crowpilot-fc/crowmotion/main/output/ppm_output.c

// SPDX-License-Identifier: Apache-2.0
// Copyright 2026 Nitin Kumar
//
// Crowmotion - hardware-timed CPPM/PPM trainer output.

#include "ppm_output.h"

#include "driver/gpio.h"
#include "driver/rmt_tx.h"
#include "esp_private/gpio.h"
#include "esp_log.h"

static const char *TAG = "ppm";

#define PPM_RESOLUTION_HZ 1000000

static rmt_channel_handle_t s_channel;
static rmt_encoder_handle_t s_encoder;
static int s_gpio = -1;
static bool s_enabled;

esp_err_t ppm_output_init(int gpio_num)
{
    s_gpio = gpio_num;

    rmt_tx_channel_config_t channel_config = {
        .gpio_num = gpio_num,
        .clk_src = RMT_CLK_SRC_DEFAULT,
        .resolution_hz = PPM_RESOLUTION_HZ,
        .mem_block_symbols = 48,
        .trans_queue_depth = 2,
        .flags.init_level = 0,
    };
    esp_err_t err = rmt_new_tx_channel(&channel_config, &s_channel);
    if (err != ESP_OK) return err;

    rmt_copy_encoder_config_t encoder_config = {};
    err = rmt_new_copy_encoder(&encoder_config, &s_encoder);
    if (err != ESP_OK) return err;

    ESP_LOGI(TAG, "PPM prepared on GPIO%d, %d us frame", gpio_num,
             CROWMOTION_PPM_FRAME_US);
    return ESP_OK;
}

esp_err_t ppm_output_set_enabled(bool enabled, bool inverted)
{
    (void)inverted;
    if (s_channel == NULL) return ESP_ERR_INVALID_STATE;
    if (enabled == s_enabled) return ESP_OK;

    esp_err_t err = ESP_OK;
    if (enabled) {
        // Disabling the output makes the pin high-impedance. Reconnect the
        // RMT signal before every enable; rmt_enable() only changes the RMT
        // state machine and does not restore GPIO-matrix routing.
        err = rmt_tx_switch_gpio(s_channel, s_gpio, false);
        if (err == ESP_OK) err = rmt_enable(s_channel);
    } else {
        err = rmt_tx_wait_all_done(s_channel, 100);
        esp_err_t disable_err = rmt_disable(s_channel);
        if (err == ESP_OK) err = disable_err;
        if (disable_err == ESP_OK) {
            // Disconnect the output driver without overwriting the pin's RMT
            // configuration. The external 100k resistor then holds tip low.
            gpio_output_disable(s_gpio);
        }
    }
    if (err == ESP_OK) s_enabled = enabled;
    return err;
}

esp_err_t ppm_output_send_frame(
    const uint16_t channels[CROWMOTION_CHANNEL_COUNT], bool inverted)
{
    if (!s_enabled) return ESP_ERR_INVALID_STATE;

    rmt_symbol_word_t symbols[CROWMOTION_CHANNEL_COUNT + 1];
    uint32_t used_us = 0;
    uint8_t active = inverted ? 0 : 1;
    uint8_t idle = inverted ? 1 : 0;

    for (int i = 0; i < CROWMOTION_CHANNEL_COUNT; i++) {
        uint16_t value = channels[i];
        if (value < CROWMOTION_CHANNEL_MIN_US) value = CROWMOTION_CHANNEL_MIN_US;
        if (value > CROWMOTION_CHANNEL_MAX_US) value = CROWMOTION_CHANNEL_MAX_US;
        symbols[i].level0 = active;
        symbols[i].duration0 = CROWMOTION_PPM_PULSE_US;
        symbols[i].level1 = idle;
        symbols[i].duration1 = value - CROWMOTION_PPM_PULSE_US;
        used_us += value;
    }

    uint32_t sync_us = CROWMOTION_PPM_FRAME_US - used_us -
                       CROWMOTION_PPM_PULSE_US;
    symbols[CROWMOTION_CHANNEL_COUNT].level0 = active;
    symbols[CROWMOTION_CHANNEL_COUNT].duration0 = CROWMOTION_PPM_PULSE_US;
    symbols[CROWMOTION_CHANNEL_COUNT].level1 = idle;
    symbols[CROWMOTION_CHANNEL_COUNT].duration1 = sync_us;

    rmt_transmit_config_t transmit_config = {
        .loop_count = 0,
        .flags.eot_level = idle,
    };
    esp_err_t err = rmt_transmit(s_channel, s_encoder, symbols,
                                 sizeof(symbols), &transmit_config);
    if (err != ESP_OK) return err;
    return rmt_tx_wait_all_done(s_channel, 100);
}
