crowpilot-fc/crowmotion/(commit log)

2026-06-28 Scaffold firmware and implement PARA BLE trainer link (M1)
    ESP-IDF + NimBLE project for XIAO ESP32-C3. Advertises the FrSky PARA service (0xFFF0), streams centered trainer channels on 0xFFF6 with the connect nudge. Apache-2.0, with credits to the projects that inspired it.
    [partitions.csv]
2026-06-28 Add MPU6500 I2C driver and raw IMU read path (M2)
    I2C master on GPIO6/7 at 0x68. Probes WHO_AM_I, configures the chip, logs accel/gyro/temp at 5 Hz. Continues without the IMU if it is not wired.
2026-06-28 Move IMU I2C to right-side pins D10 (SDA) and D7 (SCL)
    Keeps all sensor connections on one side. Avoids the D8/D9 boot strapping pins.
    [mpu6500.c, mpu6500.h]
2026-06-28 Scope v1 to a USB-powered two-component build
    Defer battery, sleep/wake, switch, and status LED to a v2.
2026-06-28 Add Madgwick 6DOF fusion and yaw/pitch/roll output (M3)
    Original IMU-only Madgwick filter. Fusion task runs at 100 Hz with a startup gyro-bias estimate and logs Euler angles at 10 Hz, replacing the raw IMU log.
2026-06-28 Make ESP32-C3 Super Mini the primary v1 board
    Same chip and GPIO numbers as the XIAO, so no firmware change. Updates docs, wiring table, and comments to be board-neutral. XIAO remains compatible.
2026-06-28 Add parametric OpenSCAD enclosure (M8)
    In-line two-piece slide box for Super Mini + MPU6500: dovetail lid with snap, chamfered USB cutout, 3mm LED hole, clip-on strap mount, and a slide-fit coupon. Support-free print orientations. Defaults for unmeasured dims.
    [freelook_case.scad]
2026-06-29 Document two-version, multi-board lineup (v1 USB, v2 battery)
    v1: C3 Super Mini USB. v2: standalone battery on XIAO ESP32-S3 or ESP32-H2 Super Mini, protected LiPo (no switch), 5-min sleep, wake-on-motion, single LED.
2026-06-29 Refresh docs to current status and multi-target build
    README status reflects M1-M3 progress and USB v1 vs battery v2; BUILD.md notes the esp32c3/esp32s3/esp32h2 targets and the real boot output.
2026-06-29 Map head orientation to PARA channels (M5)
    yaw/pitch/roll drive channels 0/1/2 with per-axis gain and inversion, relative to a startup center. The fusion loop recenters after a short settle, then pushes mapped channels each iteration.
2026-06-29 Add per-board I2C pin selection for one-side wiring
    menuconfig board choice (default C3 Super Mini: SDA=GPIO4/SCL=GPIO3; XIAO C3: SDA=GPIO10/SCL=GPIO20), both keep wiring on one side. board.h holds the per-board profile; docs updated.
2026-06-29 Add public-facing README and GitHub Pages config
    v1-focused landing page: $5 pitch, system overview, BOM, pan/tilt mount links, wiring, build, honest alpha status. Cayman theme for Pages.
2026-06-30 Fix IMU I2C: drop to 100kHz and retry first read
    The MPU6500 ACKs at 0x68 but the first 400kHz transaction returned ESP_ERR_INVALID_STATE with weak/internal pull-ups. 100kHz plus a short retry on WHO_AM_I makes init reliable.
    [mpu6500.c]
2026-06-30 Add temple-mount remap, continuous auto-cal, robust IMU detect
    Temple-mount axis remap (pan=head turn, tilt=nod), output limited to 2 axes. Continuous gyro auto-calibration (M4) tracks bias while still, removing yaw drift. IMU detection hardened: probe-based detect at 0x68/0x69, separate write-then-read, 100kHz bus.
    [mpu6500.c]
2026-06-30 Add double-tap recenter (M6)
    Tap = accel-magnitude jerk spike while not rotating fast; two taps within a time window recenter to the current heading. Channel readback accessor added for verification. Approach mirrors dlktdr's software tap detection.
2026-06-30 Add persistent config model (NVS), wire mapping/orientation/taps to it
    config struct in NVS holds channel map, orientation remap, gains, limits, deadband, tap intensity, and device name. Mapping, board remap, and tap threshold now read the live config (defaults reproduce prior behavior). Foundation for the config web UI (M9).
2026-06-30 Add config web UI over WiFi hotspot (M9)
    Quad-tap (when not radio-connected) toggles a WiFi AP serving a config web app: live output monitor, animated CSS-3D head + orientation cube over a WebSocket, channel assignment, sensitivity/range/deadband, orientation rotate/flip/auto-detect, tap intensity, device name, save/reset/export/import. Mode controller swaps BLE and WiFi (never both active). Config JSON over HTTP, all settings in NVS. Tap detection generalized to count 2/3/4 taps. Builds at 1.15MB (27% partition free). Untested on hardware - OTA deferred.
2026-06-30 Add OTA: local upload + server update check
    Dual-OTA partition layout (4MB flash). Local OTA: upload a .bin via the config page (POST /update). Server OTA: POST /checkupdate joins home WiFi (APSTA), fetches the manifest at updates.robosutra.com/freelook/latest.json, and flashes via esp_https_ota if the version differs (cert bundle for TLS). WiFi STA credentials and a version field added to the config + UI Firmware card with status polling. Builds at 1.36MB (14% slot free). Server set up later; untested on hardware.
    [partitions.csv]
2026-06-30 Add onboard status LED with state patterns (GPIO8)
    Single blue LED (active-low, strap pin driven only post-boot). Patterns: searching=slow heartbeat, connected=solid, config hotspot=double-blink, OTA=fast blink, recenter=triple-flash confirm. Errors are blink-codes (2=IMU not found). led module renders patterns from a phase counter; wired into BLE connect/disconnect, config mode, OTA, IMU fault, and recenter.
    [led.c, led.h]
2026-06-30 Rename project to CrowMotion
    Rebrand the head tracker from FreeLook to CrowMotion so it sits in the
    Crow ecosystem alongside the Crowpilot flight controller.
    - All identifiers, macros, and strings: FreeLook/FREELOOK/freelook -> CrowMotion
    - Rename freelook_main.c and freelook_case.scad to crowmotion_*
    - BLE/PARA advertised name and config-hotspot SSID prefix -> crowmotion
    - Default hotspot WPA2 password -> crowmotion
    - OTA update host -> https://updates.crowpilot.in/crowmotion/latest.json
    - Docs, README links, and Pages config point at crowpilot-fc/crowmotion
    [crowmotion_case.scad, partitions.csv]
2026-07-01 docs: document status LED, tap gestures, config UI, and OTA
    Add the previously undocumented user-facing features to the README (onboard
    LED patterns and fault codes, double/quad-tap gestures, the full WiFi config
    UI sections, and OTA). Fix the recenter wording: it is double-tap or the web
    UI button, not a BLE command.
2026-07-02 Drop XIAO support: v1 targets the ESP32-C3 Super Mini only
    Remove the XIAO ESP32-C3 board choice and v2 board mentions. BUILD.md
    wrongly claimed the XIAO was pin-identical (it uses GPIO10/20, not
    GPIO4/3), and mpu6500.h carried the stale XIAO pins in its wiring
    comment. One board, one wiring table, one tested path for v1.
    [board.h, mpu6500.h]
2026-07-02 Harden firmware: input validation, AP-only HTTP, OTA rollback, tap and yaw fixes
    - Validate every config field from JSON: remap entries restricted to
    +/-1..3 (was an out-of-bounds stack access), channels to TR1-TR8,
    deadband to >= 0, gains/ranges/tap clamped, min/max pairs reordered.
    Apply to a copy and commit under a critical section so the 100 Hz
    fusion task never sees a torn write.
    - Serve the config UI and OTA endpoints only to clients on the hotspot
    subnet; in AP+STA mode they were reachable from the home network.
    - Make the hotspot WPA2 passphrase configurable (ap_pass, 8-64 chars);
    passwords are never serialized back out.
    - Enable bootloader app rollback: a new OTA image m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
2026-07-02 Rebuild config web UI; add client-side validation and hotspot password
    Self-contained vanilla-JS single page with Live (3D head view, live
    channels), Orientation (rotate/flip/auto-detect), Channels, Response,
    Taps, Firmware (WiFi credentials, server check, local file update), and
    Device sections, wired to /config, /ws, /status, /checkupdate, /update,
    /recenter, /autodetect, and /exit.
    Client-side hardening to match the firmware: range inputs reject
    non-numeric values instead of silently clamping to 988, min/max pairs
    auto-reorder, and the Device section gains a hotspot-password field
    (8+ chars, blank keeps current).
2026-07-02 README: troubleshooting, mounting guidance, honest price framing
    Add a Troubleshooting section (LED fault code, pairing, inversion,
    drift, taps, hotspot access), document the default temple-mount
    orientation and Auto-detect, qualify the $5 claim (core parts only)
    with the cheapest-wireless positioning, note the hotspot password is
    changeable, and add the CI badge.
2026-07-02 Add CI build workflow and community files
    GitHub Actions builds every push and PR with ESP-IDF v5.5.4 for
    esp32c3 and uploads the firmware artifact. Add CONTRIBUTING, CODE_OF_
    CONDUCT (Contributor Covenant 2.1), SECURITY (private reporting, stated
    threat model), and issue/PR templates.
2026-07-02 Publish OTA updates from GitHub releases
    New release-ota workflow, triggered only when a release is published
    (never on pushes): builds the tagged source with ESP-IDF v5.5.4, fails
    if the tag does not match version.h, attaches the built .bin to the
    release, and deploys the manifest plus binary to the Cloudflare Pages
    project behind updates.crowpilot.in. Old binaries stay available on
    GitHub Releases; the update host only ever serves the newest one.
2026-07-02 Add CrowLink: wireless trainer bridge over ESP-NOW (M12)
    Tracker side: a crowlink task broadcasts the 8 trainer channels over
    ESP-NOW at 50 Hz (fixed channel 1) whenever the new bridge_en config
    toggle is on, alongside the BLE PARA link (software coexistence). The
    config hotspot borrows the WiFi radio cleanly via pause/resume hooks,
    and the config UI gains a CrowLink toggle in the Channels card. Config
    NVS version bumped to 4.
    Bridge side: new bridge/ app (ESP32-C6 Super Mini, cell on the battery
    pads, TP4054 charging) that validates broadcast frames (magic, version,
    XOR sum) and emits standard positive 8-channel PPM through the RMT
    peripheral on GPIO2 into a radio's 3.5mm trainer jack (tip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
    [bridge_main.c, ppm.c]
2026-07-02 Remove draft enclosure SCAD
    The old two-piece slide-box draft is superseded; a new case design will
    be published later as STL plus source.
    [crowmotion_case.scad]
2026-07-02 Add browser flasher, publish it from releases; version 0.1.1
    A static ESP Web Tools page at updates.crowpilot.in flashes boards
    straight from Chrome/Edge over Web Serial: the manifest maps chip
    family to firmware, so an ESP32-C3 gets CrowMotion and an ESP32-C6
    gets CrowLink, as complete merged images (bootloader + partition
    table + app) that work on factory-fresh boards.
    The release workflow now builds both targets, merges the full images
    with esptool, generates the flasher manifest, attaches all binaries to
    the GitHub release, and deploys the whole site (flasher + OTA
    manifest) to Cloudflare Pages in one shot.
2026-07-02 Add public website: crowpilot.in root and /crowmotion product page
    Production build of the Claude Design one-pager, in the config UI's
    design language with the red accent treatment: hero, how-it-works,
    features, embedded browser flasher (ESP Web Tools against
    updates.crowpilot.in), BOM and wiring tables, build steps with photo
    placeholders and a reserved video slot, configure section, CrowLink
    callout, FAQ, footer. Plus a minimal root landing page for the apex.
    Deployed as the crowpilot Cloudflare Pages project.
2026-07-02 Security hardening: supply chain, CSRF, OTA downgrade guard; v0.1.2
    From the security audit. Firmware (webconfig.c):
    - CSRF defense: state-changing endpoints (/config, /update, /recenter,
    /autodetect, /exit, /checkupdate) now reject any request carrying a
    cross-origin Origin header, closing a hotspot-CSRF vector that the
    AP-subnet check alone did not.
    - OTA downgrade guard: the update check now moves strictly forward
    (version_cmp), so a spoofed or compromised manifest cannot force a
    rollback to an older, vulnerable build.
    - client_on_ap now accepts only genuine IPv4-mapped IPv6 peers instead
    of blindly reading the low word of any AF_INET6 address.
    Supply chain:
    - All GitHub Acti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
2026-07-03 Fix stale monitor-output example in BUILD.md
    The 'what you should see' block did not match the actual firmware log
    lines (wrong service list, a nonexistent 'fusion: yaw...' line). Replace
    with the real boot output (banner, advertise with both service UUIDs,
    IMU detect + config, gyro-bias estimate, centering, ready) and note the
    IMU-missing fault path.
2026-07-03 Apply verified audit quick-fixes
    From an external read-only audit, verified against the code:
    - POST /config now returns HTTP 400 on invalid JSON instead of saving
    and replying 'ok' (the return value was ignored).
    - OTA check is single-flight: a second /checkupdate while one is running
    is refused, instead of spawning a racing task. Refactored the task
    into a worker + wrapper that clears the busy flag on every exit.
    - The device-served config page now sends a Content-Security-Policy and
    X-Content-Type-Options header (self-contained page: no external loads,
    no framing; 'unsafe-inline' kept for its own inline script/styles).
    - version_cmp comment corrected to match the code (best-effo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
2026-07-03 Signed OTA (M13): RSA-3072, CI-only build-time signing
    Sign the tracker app so devices only accept OTA images from our key,
    without hardware secure boot (no eFuses; boards stay USB-recoverable;
    only the OTA path verifies). RSA-3072 (Secure Boot V2 scheme) is the one
    app-signing scheme common to C3/S3/C6/H2, so a single key covers the
    whole family.
    - sdkconfig.ci.signed: CI-only overlay (signed-apps + verify-on-update +
    build-signed-binaries + signing-key path). NOT in sdkconfig.defaults,
    so local and contributor builds stay unsigned and need no key.
    - release-ota.yml: decode the private key from the OTA_SIGNING_KEY_B64
    secret, layer the overlay onto defaults for the tracker build, the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
2026-07-03 Clear UX for updates that reboot or drop the hotspot
    Reboots and hotspot teardown were read as failures: a successful local
    update raced the 500 ms pre-reboot delay so the browser's fetch threw and
    was reported as 'Upload failed', then the intentional hotspot drop showed
    the alarming 'Can't reach CrowMotion' banner with no explanation.
    Firmware (webconfig.c):
    - Local /update reply now flushes before reboot (500 -> 1500 ms), so the
    success response reliably reaches the client.
    - A rejected image returns a clear 400 'firmware rejected: invalid or
    unsigned image' (was a generic 500 'image invalid') and drops back to
    the config LED pattern; the device keeps its firmware and the hotspot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
2026-07-03 Home WiFi UX + reach config over the LAN at crowmotion-XXXX.local
    Home WiFi was confusing: no Save button (it saved only via the Device
    Save or Check-for-updates), no explanation, and the tracker's config
    page was reachable only over the hotspot.
    - UI: a dedicated 'Save WiFi' button in the Firmware section, clearer
    help text, and a line showing this tracker's http://crowmotion-XXXX.local
    address as a tappable link (with a note to switch to home WiFi first,
    since the hotspot has no route to the LAN).
    - Firmware: advertise mDNS crowmotion-XXXX.local in config mode (unique
    per device - same MAC suffix as the hotspot SSID, so multiple trackers
    never collide). New /info endpoint report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
2026-07-03 Website copy pass: lead with $5 plus cheap extension, cut repetition
    Hero rewritten to carry the core pitch (build for ~$5, extend to any radio
    with an $8 dongle) instead of repeating the H1 and the radio pill. Each
    message now has one home: the dark CrowLink section keeps the hook, the
    compatible-radios section keeps the detail, the FAQ answer no longer repeats
    itself. Accuracy fixes: 'almost any radio' used consistently, 'four wires plus
    a jumper' matches the Build headline, 'truly wireless' reworded since v1 is
    USB-powered. CTAs now follow the funnel (Build one, then Flash), nav gains a
    Radios link, BUILD.md and 'let us know' are real links, and two FAQ entries
    added (power, latency).
2026-07-03 Website: DIY framing for the dongle, dual currency pricing
    The hero no longer implies a ready-made dongle to buy; radios without
    Bluetooth 'add a simple DIY dongle'. The CrowLink section and compatible-
    radios card say you build it yourself. All prices use the $ symbol with a
    rupee equivalent ($5 / Rs 500 anchor) across the hero, radios cards,
    features, and BOM.
2026-07-03 Website: BOM calculator on the product page, full CrowLink page
    CrowMotion Build section now opens with a pick-your-radio calculator
    (CSS-only, hidden radio inputs + :checked, no JS so the CSP stays strict):
    FrSky Bluetooth-trainer radios get the ~$5 tracker list, everything else
    gets tracker + CrowLink dongle parts totaling ~$13. The compatible-radios
    intro links to it.
    The /crowlink placeholder is replaced by the full product page: hero,
    why + signal-chain diagram, how it works, safety (trainer override,
    quarter-second failsafe), compatible radios, BOM, browser flasher, and a
    three-step setup guide (bridge toggle, plug in, radio trainer mode).
    Rupee equivalents added at 1:95 rounded to Rs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
2026-07-03 Website: On the aircraft section - pan/tilt mounts and servos
    New section between Build and Configure: what moves the camera (two 9g
    micro servos in a printed pan/tilt mount, ~$2 each), three featured-mount
    placeholder cards with STL links to fill in later, and search buttons for
    MakerWorld, Printables, and Thingiverse. Linked from the nav, from the
    'two servos' mention in How it works, and from a BOM calculator footnote
    so the shopping list stays honest about the aircraft side.
2026-07-06 Website: setup guide - from parts to first flight
    New page at /crowmotion/guide/ covering the full chain: how it fits
    together (extended signal diagram), tracker configuration (hotspot,
    orientation auto-detect, TR1/TR2 defaults, LED cheat sheet), radio
    connection over both paths (EthOS Bluetooth with screenshot placeholders
    pending verified menus; CrowLink flagged pending bench test), the mixer
    step that first-timers get stuck on (TR1/TR2 onto free channels behind a
    switch), the aircraft side (receiver slots, center-before-assembly,
    direction checks via Invert), and preflight checks plus troubleshooting.
    Documents released firmware v0.1.2 only. Linked from the product page
    nav, the Build sec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
2026-07-16 Tracker builds for esp32c3, esp32s3, and esp32c6
    Board profiles (Kconfig + board.h) now cover the C3, C6, and S3 Super Mini
    boards, defaulting to the board that matches the IDF target. The C3 remains
    the hardware-verified v1 board; the C6 and S3 pin maps are from pinouts and
    are flagged pending bench verification. The status LED driver gains a WS2812
    backend for the S3's addressable RGB LED (espressif/led_strip, pinned).
    OTA becomes per-target: devices fetch latest-<target>.json (same schema),
    while the release workflow keeps the legacy latest.json and image name for
    fielded C3 devices on 0.1.2 or older. The browser flasher gets per-product
    manifests (crowmotion.json with all three chips, c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
    [partitions.csv]
2026-07-19 Website: replace product site with a coming-soon holding page
    Take the public crowpilot.in marketing site down to a single minimal
    holding page. The CrowMotion product page + setup guide and the CrowLink
    page are removed from the deployed site (fully recoverable from git
    history: commits a617545, bb6738e, 558a818, and this range). A _redirects
    catch-all sends every old URL to the holding page, and the deploy
    workflow's version-stamp step is dropped since the product page it targeted
    is gone.
    Does not touch updates.crowpilot.in (OTA manifests + browser flasher);
    fielded devices and the flasher keep working.
2026-09-02 Replace prototype with integrated CrowMotion hardware
2026-09-03 Harden trainer output and IMU fail-safes
